Dua-Saeed641/MOIST/web/src/assets/glove.webp

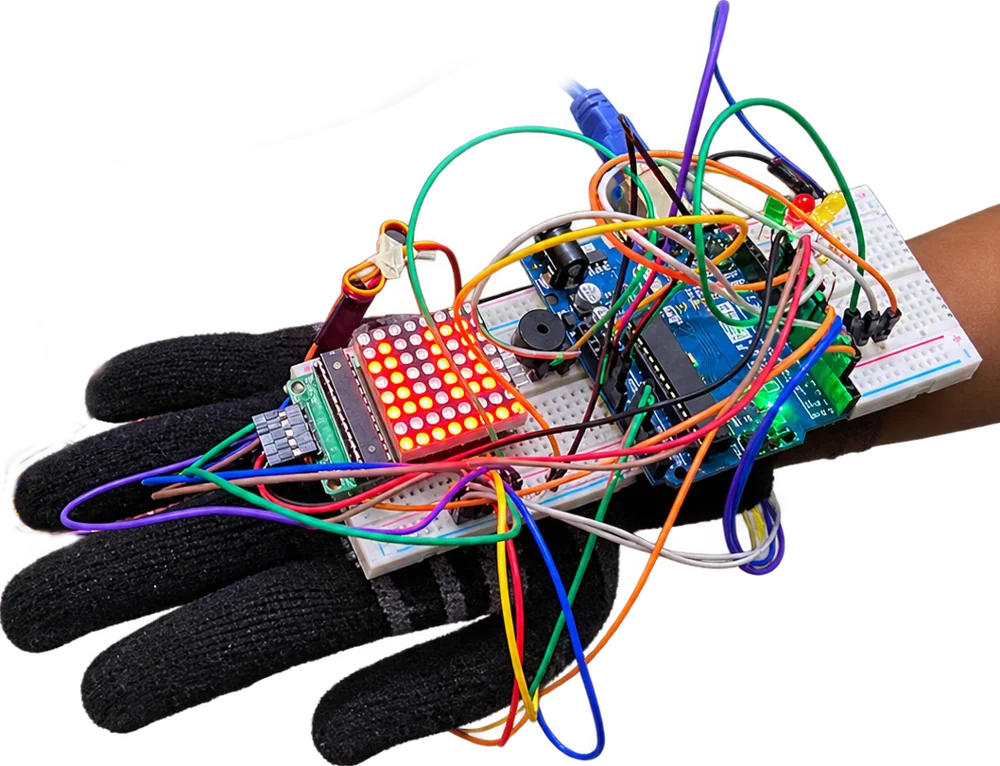
web/src/assets/glove.webp
