Dua-Saeed641/MOIST/web/src/assets/meadow.webp

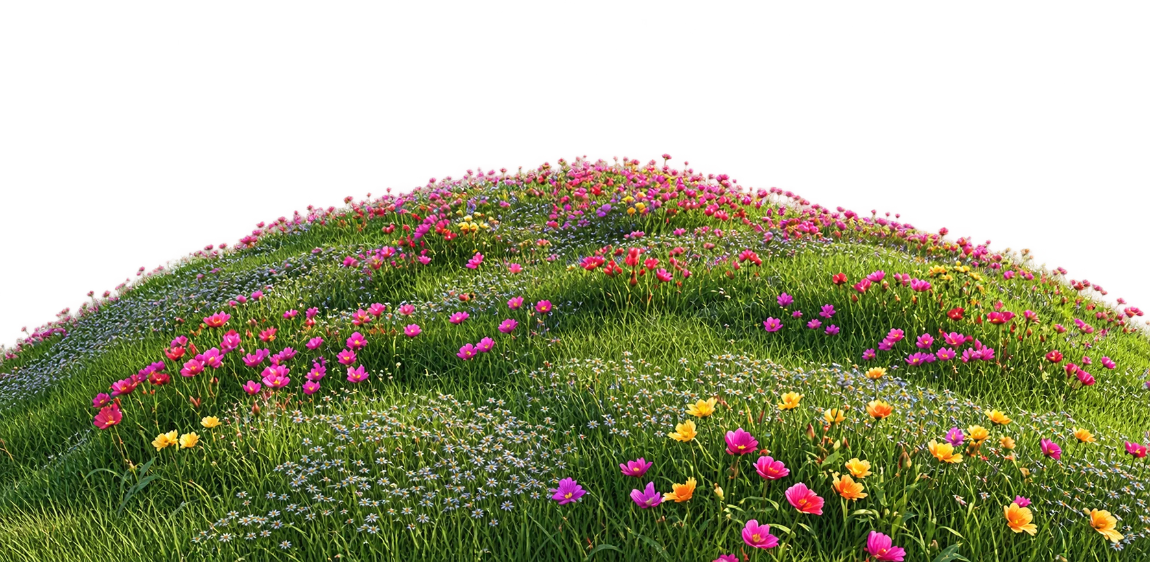
web/src/assets/meadow.webp
